pachir1su/2026_U-CAST/CHATGPT.md

# CHATGPT.md

ChatGPT와 Codex는 작업을 시작하기 전에 저장소 루트의 `AGENTS.md`를 **전부 읽고**
그 규칙을 따릅니다. 저장소 공통 규칙(환경, 원자 커밋, 개인정보 취급, 테스트 표현,
릴리스 정책)은 모두 `AGENTS.md`에 있으며, 이 파일에는 복사하지 않습니다.

ChatGPT / Codex에만 추가로 적용하는 규칙:

- 관련 GitHub issue의 본문과 댓글을 먼저 읽습니다.
- 저장소 파일을 직접 열어 확인한 내용만 근거로 씁니다. 기억이나 추측으로
  `main.ino`의 상수·핀 번호를 적지 않습니다.
- 코드를 제안할 때는 변경 파일과 변경 이유를 먼저 정리한 뒤 diff를 만듭니다.
- 브라우저 세션 등으로 파일을 직접 커밋할 수 없는 상황이면, 사용자가 그대로
  복사할 수 있는 전체 파일 내용과 파일 경로를 함께 제공합니다.
- Draft PR까지만 만들고 자동 병합하지 않습니다.
