pachir1su/2026_U-CAST/docs/images/5조 회로 구성 예시.png

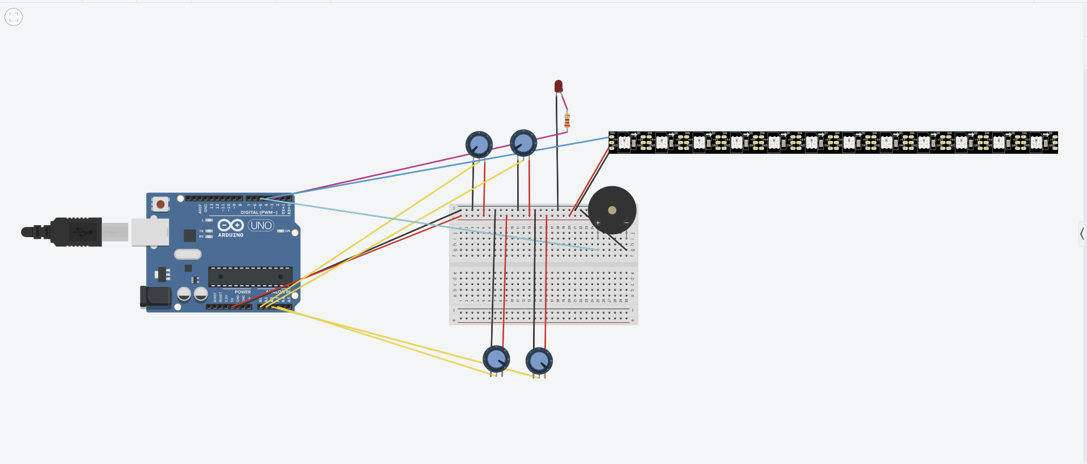
docs/images/5조 회로 구성 예시.png
