pachir1su/2026_U-CAST/docs/images/5조 아두이노 스키매틱.pdf

A

1 | 2 | 3 | 4 | 5 | 6

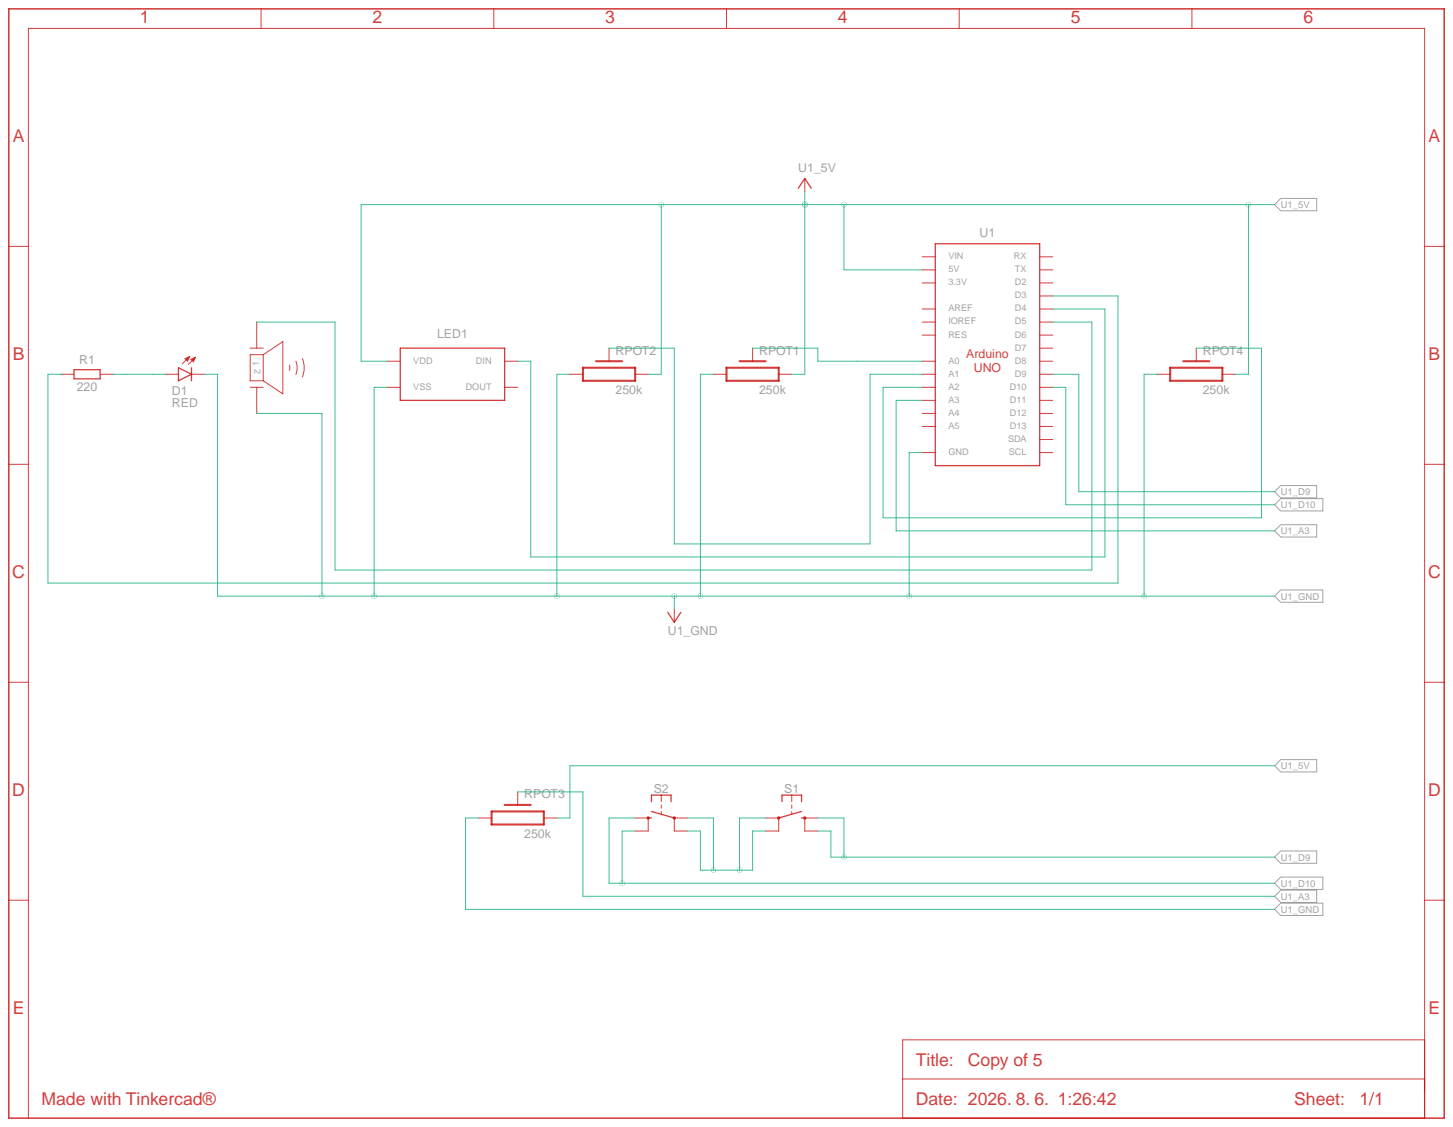
[picture p2: page 1]
