pachir1su/2026_U-CAST/docs/images/Copy of 5팀.pdf

A

1 | 2 | 3 | 4 | 5 | 6

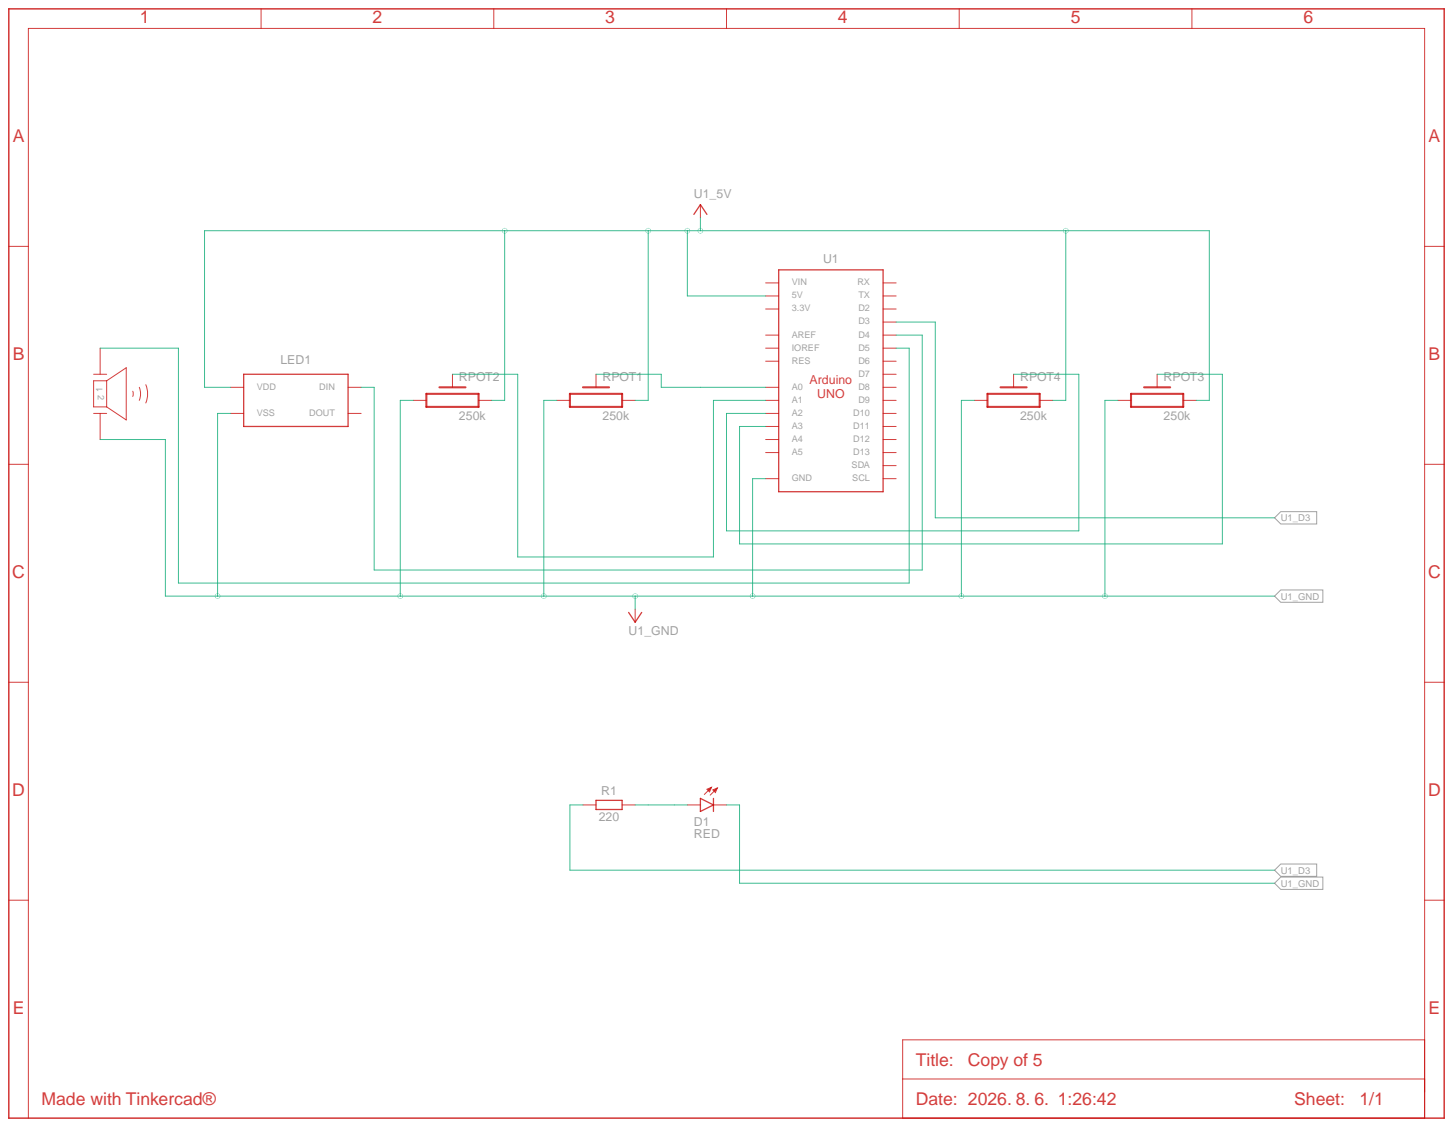
[picture p3: page 1]
