pachir1su/2026_U-CAST/(commit log)

2026-08-04 무단횡단 방지 시스템 3차시 워크북 기준 구현
    3차시 팀 제작 워크북(5팀)의 부품 목록과 설계서를 기준으로 스케치를
    전면 재작성하고, 핀 연결표와 워크북 빈칸 초안 문서를 추가한다.
    main.ino
    - IR 센서 4개(진입 감지 쌍 / 통과 감지 쌍), 네오픽셀 스트립 2개,
    부저, 빨간색 LED, 수동 조작 버튼 2개 구성으로 확장
    - 스트립 2개 모두 차도에 설치하여 운전자에게 횡단 중임을 경고하는
    용도로 사용. 횡단보도 방향으로 흐르는 애니메이션 적용
    - delay() 기반 폴링을 millis() 기반 상태 기계로 교체하여 경고 중에도
    센서와 버튼 입력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
2026-08-04 AI 코딩 도구 공통 작업 규칙 문서 추가 (#2)
    Claude-Session: https://claude.ai/code/session_01LwB7ARSinFCx5eRdrgAHWV
2026-08-04 Claude Code 전용 추가 규칙 문서 추가 (#2)
    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
2026-08-04 ChatGPT/Codex 전용 추가 규칙 문서 추가 (#2)
    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
2026-08-04 브레드보드 배선도 이미지 추가 (#3)
    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
2026-08-04 동작 상태 흐름도 이미지 추가 (#3)
    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
2026-08-04 4차시 브레드보드 조립 가이드 문서 추가 (#4)
    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
2026-08-04 증상별 문제 해결 가이드 문서 추가 (#4)
    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
2026-08-04 팀원/멘토 구분 및 문서·이미지 링크 반영 (#3, #4, #5)
    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
2026-08-04 워크북 팀 정보에 멘토 구분과 역할 빈칸 반영 (#5)
    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
2026-08-05 feat: 양방향 IR 브레이크빔 상태 머신 적용
2026-08-05 docs: 최종 양방향 경고 설계로 README 갱신
2026-08-05 docs: 3차시 워크북을 최종 IR 설계로 정리
2026-08-05 docs: IR 브레이크빔 조립 가이드 갱신
2026-08-05 docs: 브레이크빔 문제 해결 절차 갱신
2026-08-05 docs: 양방향 IR 브레이크빔 배선도 갱신
2026-08-05 docs: 양방향 상태 흐름도 갱신
2026-08-06 fix: 워크북 기준 진입·통과 상태 머신 복구
    방향 판정 3상태(STATE_LEFT_TO_RIGHT/STATE_RIGHT_TO_LEFT)를 제거하고 워크북
    5·6·7·8장 기준의 STATE_IDLE / STATE_WARNING 2상태로 되돌립니다.
    - 진입 감지 IR 2개(D2·D3), 통과 감지 IR 2개(D4·D5)로 입력 확장
    - 빨간 버튼(A0)=경고 수동 시작, 초록 버튼(A1)=경고 수동 종료로 복구
    - CROSSING_MIN_MS, CROSSING_TIMEOUT_MS, pendingArrival 제거
    - 자동 종료는 기본 비활성 선택 기능(WARNING_TIMEOUT_MS = 0)으로만 유지
    - 스트립 2줄은 경고 중 전체 빨간색 점등, 빨간 LED와 부저만 300ms 점멸
    - 대기 상태에서 진입·통과 동시 감지는 모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
    [main.ino]
2026-08-06 docs: 핀 연결과 시작·종료 버튼 의미 수정
    Claude-Session: https://claude.ai/code/session_01BuGFoPjX52o4dHr4hZ3yan
2026-08-06 docs: 워크북 초안을 5·7·8장 기준으로 정리
    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
2026-08-06 docs: 제작 가이드를 진입·통과 IR 기준으로 수정
    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
2026-08-06 docs: 문제 해결 절차를 진입·통과 IR 기준으로 수정
    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
2026-08-06 docs: 배선도에 IR 4개와 A0·A1 버튼 반영
    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
2026-08-06 docs: 상태 흐름도를 대기·경고 2상태로 단순화
    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
2026-08-06 test: 테스트용 Arduino 스텁 추가
    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
2026-08-06 test: 테스트용 NeoPixel 스텁 추가
    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
2026-08-06 test: 워크북 알고리즘 회귀 테스트 추가
    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
2026-08-06 test: 회귀 테스트 실행 스크립트 추가
    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
2026-08-06 chore: 테스트 빌드 산출물 무시
    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
2026-08-06 feat: Tinkercad 시뮬레이션 스케치 추가
    실물 회로는 IR 센서 4개(D2~D5)를 쓰지만 Tinkercad에는 디지털 IR 모듈이 없어
    가변저항 4개(A0~A3)로 대체한 시뮬레이션 전용 스케치를 test/test.ino로 추가한다.
    - 진입 A0·A1, 통과 A2·A3, 빨간 버튼 D9, 초록 버튼 D10
    - 빨간 경고 LED D3, 네오픽셀 스트립 1줄 D4, 부저 D5
    - 상태 전이·동시 입력 정책은 main.ino와 동일하게 유지
    - delay() 없이 millis() 기반, 부저는 tone()/noTone() 사용
    - 임계값 근처 떨림을 막는 히스테리시스(POT_HYSTERESIS) 적용
    main.ino 옆이 아니라 test/ 폴더에 두어야 Arduino IDE가 두 스케치를 합쳐
    set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
2026-08-06 docs: 시뮬레이션 스케치와 회로 자료 안내 추가
    - 8장에 실물/시뮬레이션 핀 배정 대조표와 test/ 폴더 규칙 설명 추가
    - 업로드된 회로 구성 예시 이미지와 스키매틱 PDF 링크 연결
    - 11장 파일 구성에 test/test.ino와 회로 자료 반영
    Claude-Session: https://claude.ai/code/session_01Qm83Ecb8ZjHW9Ve82XBPDb
2026-08-06 feat: 스트립 1줄(10픽셀)로 확정하고 초보자용 주석 보강 (#9)
    Claude-Session: https://claude.ai/code/session_01P6tDMEaYjfvyN2UJmEuM1r
2026-08-06 feat: 시뮬레이션 스케치를 IR 2개 실물 축소판으로 교체
    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
2026-08-06 test: 단일 스트립 기준으로 회귀 테스트 갱신
    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
2026-08-06 test: NeoPixel 스텁 설명을 단일 스트립 기준으로 수정
    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
2026-08-06 docs: 스트립 1줄과 IR 2개 축소판 스케치를 README에 반영
    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
2026-08-06 docs: 제작 가이드를 스트립 1줄·IR 단계별 확장 기준으로 수정
    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
2026-08-06 docs: 문제 해결 가이드를 스트립 1줄 기준으로 수정
    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
2026-08-06 docs: 워크북 부품·핀 표를 스트립 1줄로 갱신
    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
2026-08-06 docs: 배선도를 스트립 1줄(D6)로 수정
    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
2026-08-06 feat: 양방향 횡단 감지로 전환하고 스트립 2줄·실물 핀맵 반영
    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
2026-08-06 feat: 축소판 스케치를 양방향·자가진단·IR 로그 지원으로 개편
    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
2026-08-06 test: 양방향 상태 머신 회귀 테스트로 재작성
    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
2026-08-06 test: Serial 스텁에 정수 출력 오버로드 추가
    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
2026-08-06 docs: README를 양방향 동작과 새 핀맵 기준으로 갱신
    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
2026-08-06 docs: 제작 가이드를 양방향 배치와 스트립 2줄 기준으로 수정
    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
2026-08-06 docs: 반사형 IR 간섭과 양방향 증상 문제 해결 항목 추가
    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
2026-08-06 docs: 워크북을 양방향 설계와 새 핀 연결표로 갱신
    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
2026-08-06 docs: 배선도를 양방향 IR 배치와 새 핀맵으로 수정
    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
2026-08-06 docs: 상태 흐름도를 양방향 기준으로 수정
    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
2026-08-06 feat: main.ino에 비차단 사이렌 부저와 시리얼 진단 로그 추가
    - 고정 1000Hz 단일음을 800Hz↔1800Hz 사이렌으로 교체.
    SIREN_MIN_HZ / SIREN_MAX_HZ / SIREN_SWEEP_MS / SIREN_UPDATE_MS 상수로 조정.
    - 상승·하강 각 500ms, 25ms마다 정수 연산으로 주파수 갱신. delay() 미사용.
    - 빨간 LED 점멸과 부저를 분리해 경고 중 소리가 끊기지 않게 함.
    - 경고 종료 시 즉시 noTone().
    - logIrValues()로 IR 4개 핀값·판정, 상태, 출발 쪽, 스트립·LED·부저 상태,
    자동 복귀 남은 시간을 IR_LOG_INTERVAL_MS(400ms)마다 출력.
    Refs #13, #14
    Claude-Session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
2026-08-06 feat: 축소판 스케치에 main.ino와 같은 사이렌·진단 로그 적용
    - 같은 SIREN_* 상수와 같은 비차단 사이렌 로직 사용.
    - 기존 logIrValues()를 확장해 상태·출발 쪽·출력 상태·자동 복귀 남은 시간 포함.
    - 부팅 자가진단에서도 실제 경고와 같은 사이렌으로 울려 소리 배선을 확인.
    Claude-Session: https://claude.ai/code/session_01BnwETYWF2C2Si8r9tf4D2R
    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
2026-08-06 test: 시리얼 로그 줄 수를 세는 스텁 카운터 추가
    로그 간격 제한 검증이 화면 출력 설정에 좌우되지 않도록 println() 호출 횟수를
    board.serialLines에 기록합니다.
    Refs #13
    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
2026-08-06 test: 사이렌·진단 로그 회귀 테스트 추가
    - 사이렌 최저·최고 주파수 범위와 500ms 상승·하강 전환
    - millis() 오버플로 구간에서의 사이렌 유지
    - 반대편 도착·초록 버튼으로 사이렌 중 종료, 종료 즉시 noTone()
    - 주기 로그가 IR_LOG_INTERVAL_MS 간격으로만 나오는지(0이면 출력 없음)
    기존 19번(부저가 LED와 함께 점멸) 테스트는 끊기지 않는 사이렌 검증으로 대체.
    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
2026-08-06 test: test/test.ino가 main.ino와 같은 사이렌·로그 동작인지 검증
    두 스케치는 각각 setup()/loop()를 정의해 한 실행 파일에 넣을 수 없으므로
    축소판을 별도 실행 파일로 컴파일해 상수와 동작 일치를 확인합니다.
    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
2026-08-06 test: 축소판·로그 끔 빌드까지 함께 실행
    main.ino 테스트, 축소판 테스트, IR_LOG_INTERVAL_MS=0 빌드 세 가지를 실행합니다.
    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
2026-08-06 docs: 사이렌 부저와 시리얼 진단 로그 설명 반영
    - 부저 사이렌 동작과 SIREN_* 조정값, 수동 부저 필요 조건 추가
    - 진단 로그 형식과 항목 설명 추가
    - 테스트 구성(32개 + 축소판 5개 + 로그 끔 빌드) 갱신
    - 코드와 어긋나 있던 IR_CONFIRM_MS(80→60), IR_USE_INTERNAL_PULLUP(true→false) 정정
    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
2026-08-06 docs: 제작 가이드에 사이렌 확인 절차와 진단 로그 예시 반영
    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
2026-08-06 docs: 문제 해결 가이드의 부저 항목을 사이렌 기준으로 갱신
    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
2026-08-06 docs: 워크북 초안의 경고 출력 설명을 사이렌 기준으로 갱신
    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
2026-08-11 docs: AGENTS.md 프로젝트명과 독립 채널 원칙 갱신
    이슈 #6, #18 반영.
2026-08-11 docs: README 프로젝트명과 독립 채널 구조 반영
    이슈 #6 프로젝트명 확정(멈춰 !), 이슈 #18 채널별 독립 IR·스트립 구조로 갱신.
    base(v0.6.2 이후 main)의 문제 정의·부품 목록·배선 세부·코드 구조·알려진 제약 등
    이슈와 무관한 기존 내용은 보존하고, 이름과 채널 구조에 관련된 부분만 교체.
2026-08-11 fix: 채널별 독립 시작·종료 IR-스트립 로직으로 전환
    전역 양방향 상태를 제거하고 시작 IR + 끝 IR + 스트립을 독립 채널 2개로
    분리. 공용 경고 LED·부저는 하나 이상의 채널 활성 시 동작. 진단 로그는
    그 loop의 detectedEdge() 판정 이후 값을 찍도록 logIrValues() 호출 위치를
    버튼 처리 이전, 엣지 판정 이후로 이동. 이슈 #18.
    [main.ino]
2026-08-11 test: 축소판 스케치를 단일 채널(D8 시작/D9 끝/D4 스트립) 기준으로 정리
    이슈 #18 독립 채널 구조에 맞춰 테스트판 스케치 갱신하고, main.ino와 같은
    이유로 logIrValues() 호출을 detectedEdge() 판정 이후로 이동.
2026-08-11 chore: 중복 LED 스트립 점멸 테스트 스케치 제거
    test/ 폴더에 남아 있던 중복 .ino 삭제.
2026-08-11 docs: 조립 가이드를 새 프로젝트명·독립 채널 배선 기준으로 갱신
    base의 단계별 조립 순서(0~5단계), 모형 배치 권장안, 상태 머신 회귀 테스트,
    제작 후 기록 절은 그대로 유지하고 양방향 관련 서술만 채널별 서술로 교체.
2026-08-11 docs: 문제 해결 가이드의 기대 로그·프로젝트명 갱신
    base의 업로드 단계/IR 센서/버튼/LED 스트립/빨간 LED/부저/상태 전환/발표
    당일 비상 대응 절 구조와 표를 유지하고, 양방향 관련 증상·조치만 채널별
    증상·조치로 교체.
2026-08-11 docs: 3회차 워크북의 프로젝트명 갱신(역사적 프롬프트 인용은 원문 유지)
    base에 있던 '가장 불편한 순간', '제외하는 이유', '나중에 개선하고 싶은
    기능', 미사용 초음파 센서 행 등 이슈와 무관한 기존 내용을 복구.
2026-08-11 docs: 상태 흐름도를 독립 채널 구조로 갱신
2026-08-11 docs: 배선도 제목·구성을 새 프로젝트명과 독립 채널 구조로 갱신
2026-08-11 test: 회귀 테스트 실행 스크립트를 새 테스트 구성에 맞게 정리
2026-08-11 test: 축소판 회귀 테스트를 단일 채널 구조 기준으로 갱신
    base에 있던 사이렌 상승·하강 주기 검증, 즉시 noTone 주파수 확인, 자동
    복귀 후 무음 확인, 주기 로그 간격 검증 테스트를 복구.
2026-08-11 test: 상태 머신 회귀 테스트를 독립 채널 2개 구조 기준으로 갱신
    base에 있던 버튼 길게 누르기, IR 유지 상태 재시작 없음, 종료 시 전체
    출력 즉시 소등, 사이렌 상승·하강 주기, 즉시 noTone, 사이렌 상수, 스트립
    픽셀 수, 경고 중 주기 로그 테스트를 독립 채널 구조에 맞게 복구.
2026-08-11 fix: PIN_STRIP_2 중복 선언 제거하고 기본값을 D6으로 확정
    PIN_STRIP_2가 별도 const와 PIN_STRIP_2_VALUE 매크로로 이중 선언되어 있던
    문제를 제거하고, 매크로 방식 선언 하나만 남겼습니다. 기본값도 미정(0)에서
    확정된 D6으로 갱신했습니다. 채널 1·2 독립 동작 로직은 변경하지 않았습니다.
    [main.ino]
2026-08-11 test: 삭제됐던 test_led_strip_blink.ino를 독립 스케치로 복구
    과거 실물에서 정상 동작을 확인했던 LED 스트립 점멸 테스트 스케치를
    test/test_led_strip_blink/ 하위의 독립 스케치 폴더로 복구했습니다.
    test/test.ino와 같은 폴더에 두면 Arduino IDE가 두 .ino를 합쳐 컴파일해
    setup()/loop() 중복 정의 오류가 나므로 별도 폴더를 사용합니다. 알고리즘은
    재작성하지 않고 원본 그대로 보존했습니다.
2026-08-11 test: PIN_STRIP_2 미연결/D6 연결 구성을 각각 명시적으로 테스트
    기본 빌드가 main.ino의 PIN_STRIP_2_VALUE 기본값 변경(6)을 그대로 물려받아
    두 번째 빌드(-DPIN_STRIP_2_VALUE=6)와 같은 구성을 중복 검증하고 있었습니다.
    기본 빌드를 -DPIN_STRIP_2_VALUE=0(미연결) 구성으로 명시하고, 이름도
    test_state_machine_no_strip2로 바꿔 미연결/D6 연결 두 구성을 각각 검증하도록
    정리했습니다. no-log 테스트 등 나머지 구성은 그대로 유지했습니다.
